Loredati-svg/Custom_Keyboard/Images/Bot_layout.png

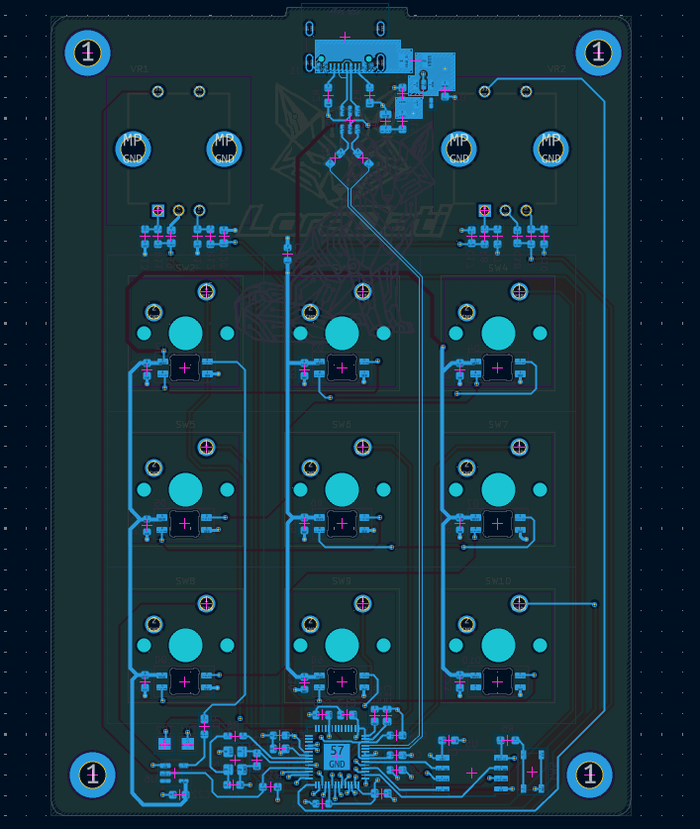
Images/Bot_layout.png
