Loredati-svg/Custom_Keyboard/Images/GND_Plane.png

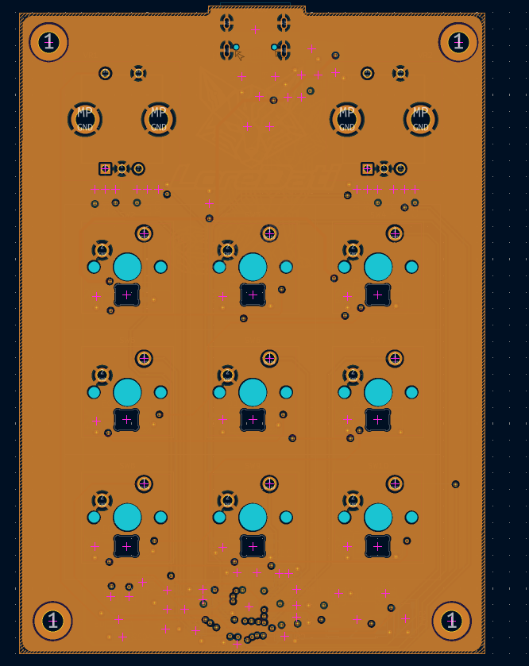
Images/GND_Plane.png
