Loredati-svg/Custom_Keyboard/Images/POWER_Plane.png

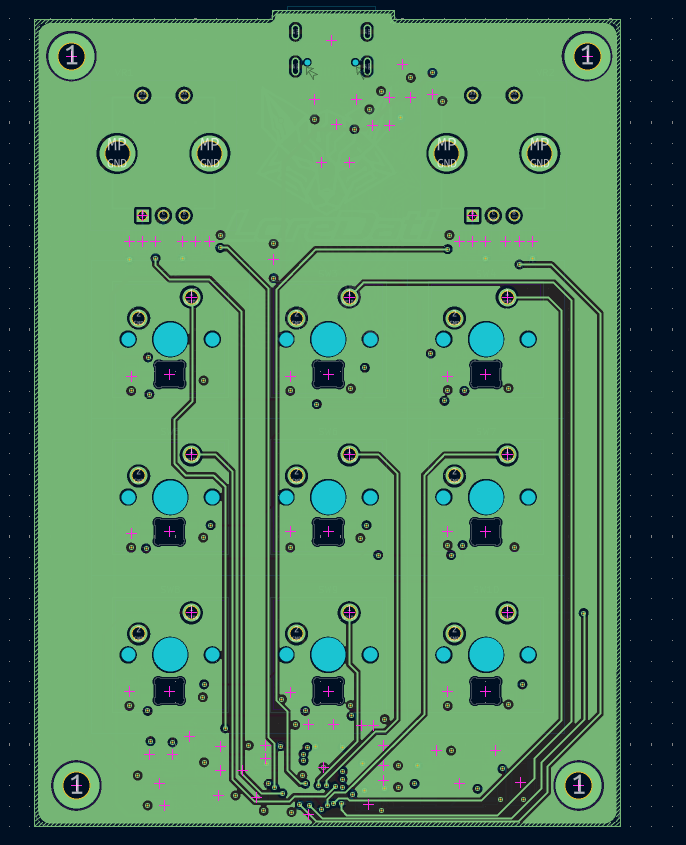
Images/POWER_Plane.png
