Loredati-svg/Custom_Keyboard/Images/Top_layout.png

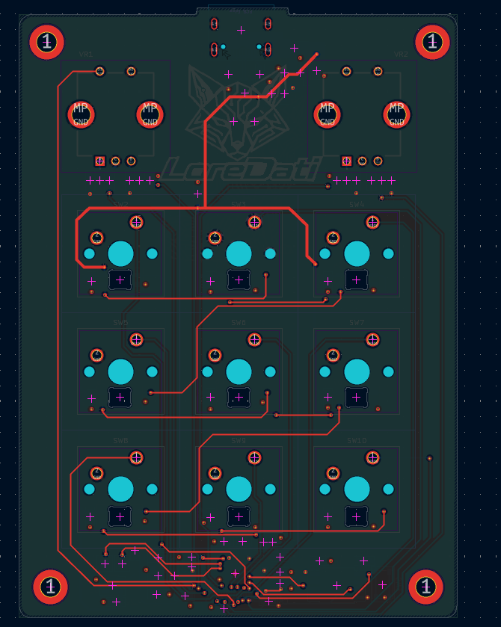
Images/Top_layout.png
