Loredati-svg/Custom_Keyboard/Kicad_Project/Custom_keyboard/Custom_keyboard.pdf

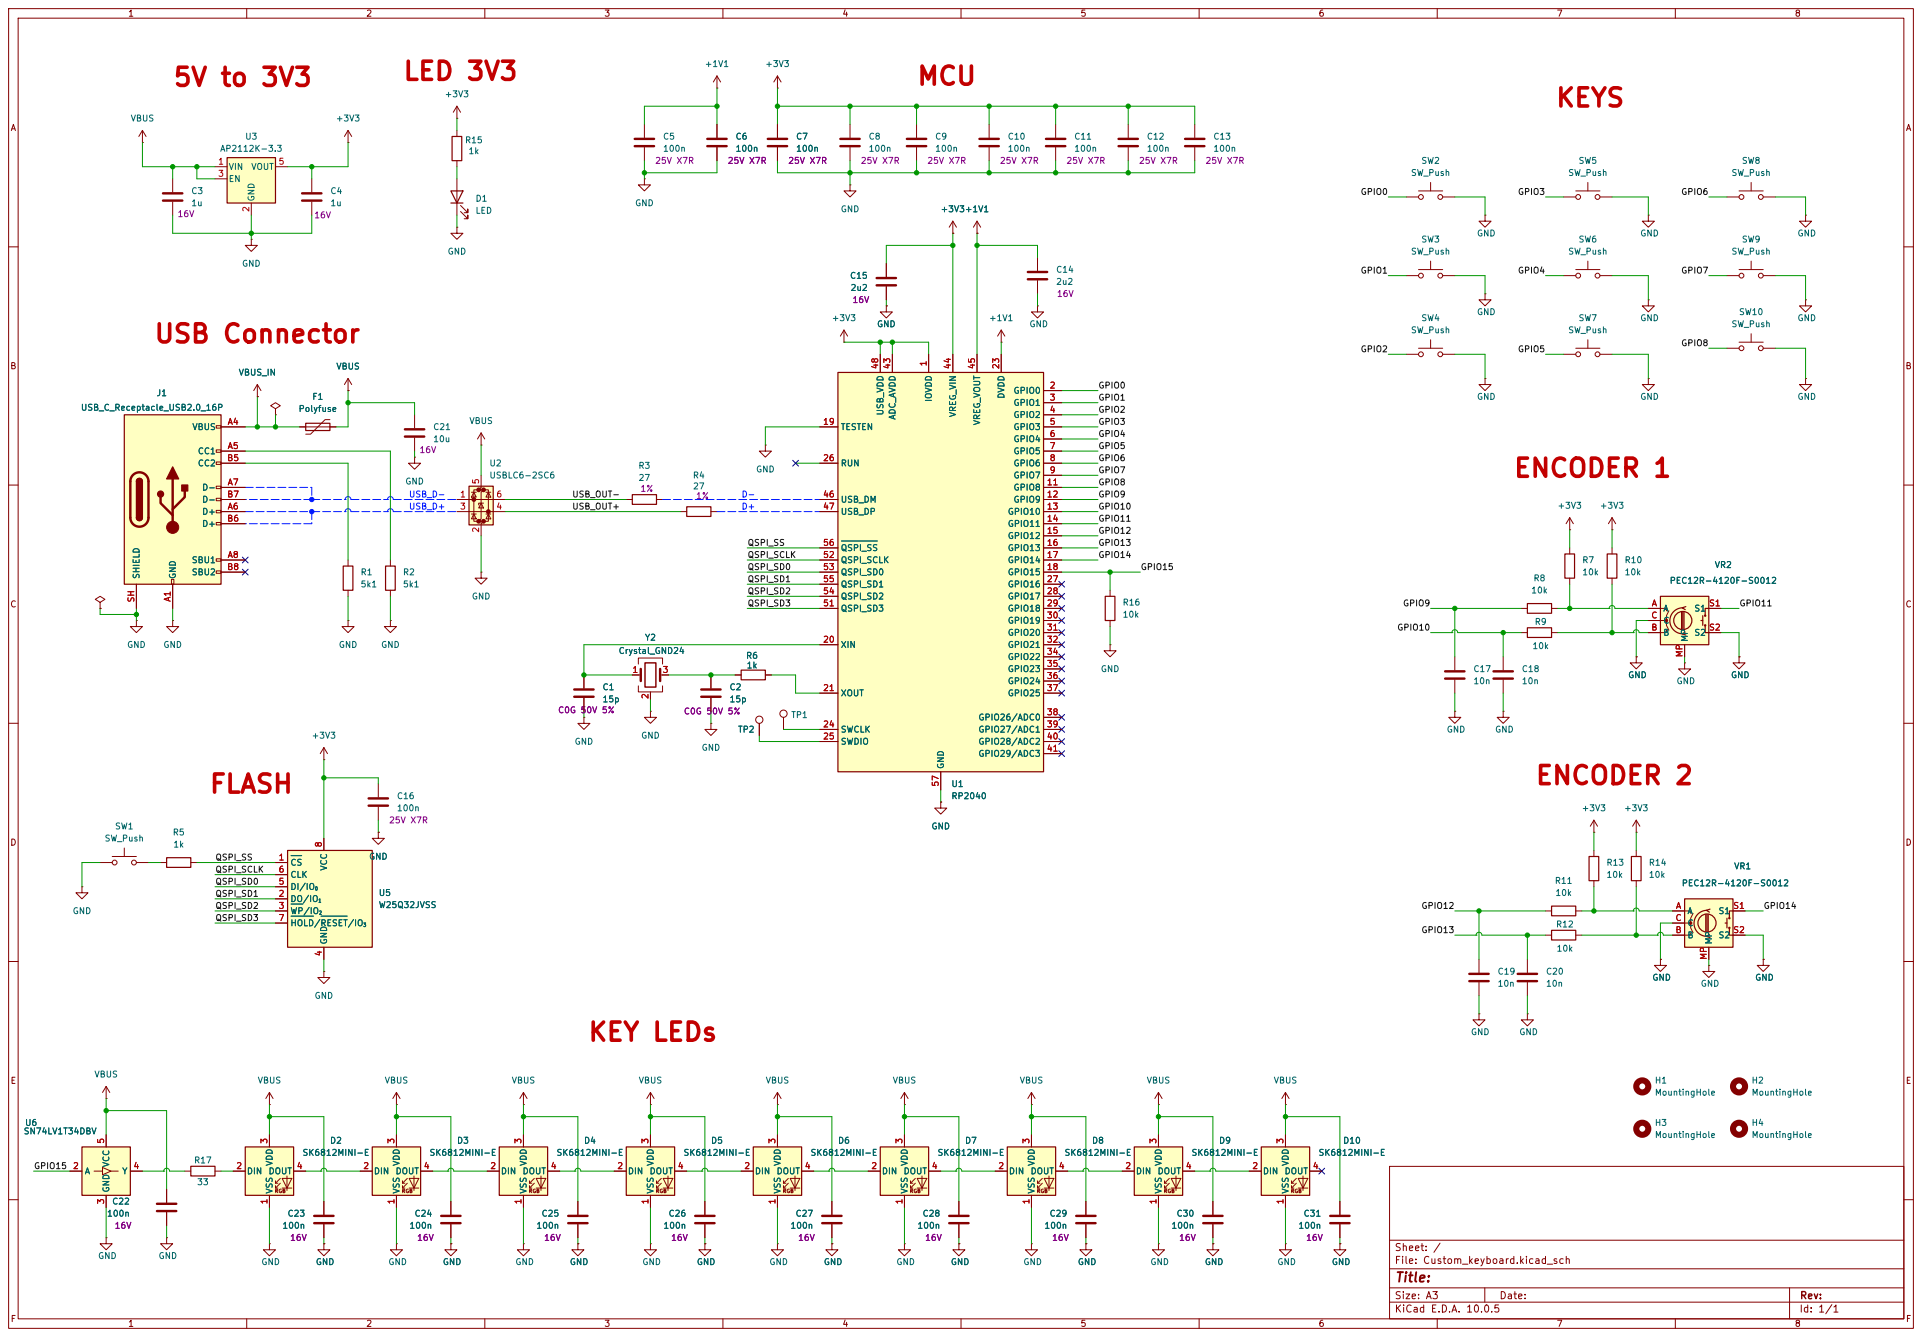
[picture p7: page 1]

8 U5W25Q32JVSS VSS RGB 1 DIN 2 VDD

3 DOUT 4 GNDU5W25Q32JVSS CS 1 DO/IO1 2 WP/IO2 3 GND

4 DI/IO0 5 CLK 6 HOLD/RESET/IO3 7 VCC

Size: A3 | Rev: | F Date:
KiCad E.D.A. 10.0.5 | Id: 1/1
