Loredati-svg/Custom_Keyboard/Kicad_Project/Custom_keyboard/Custom_keyboard.kicad_pcb

## KiCad design Kicad_Project/Custom_keyboard/Custom_keyboard.kicad_pcb (2026-10-20)

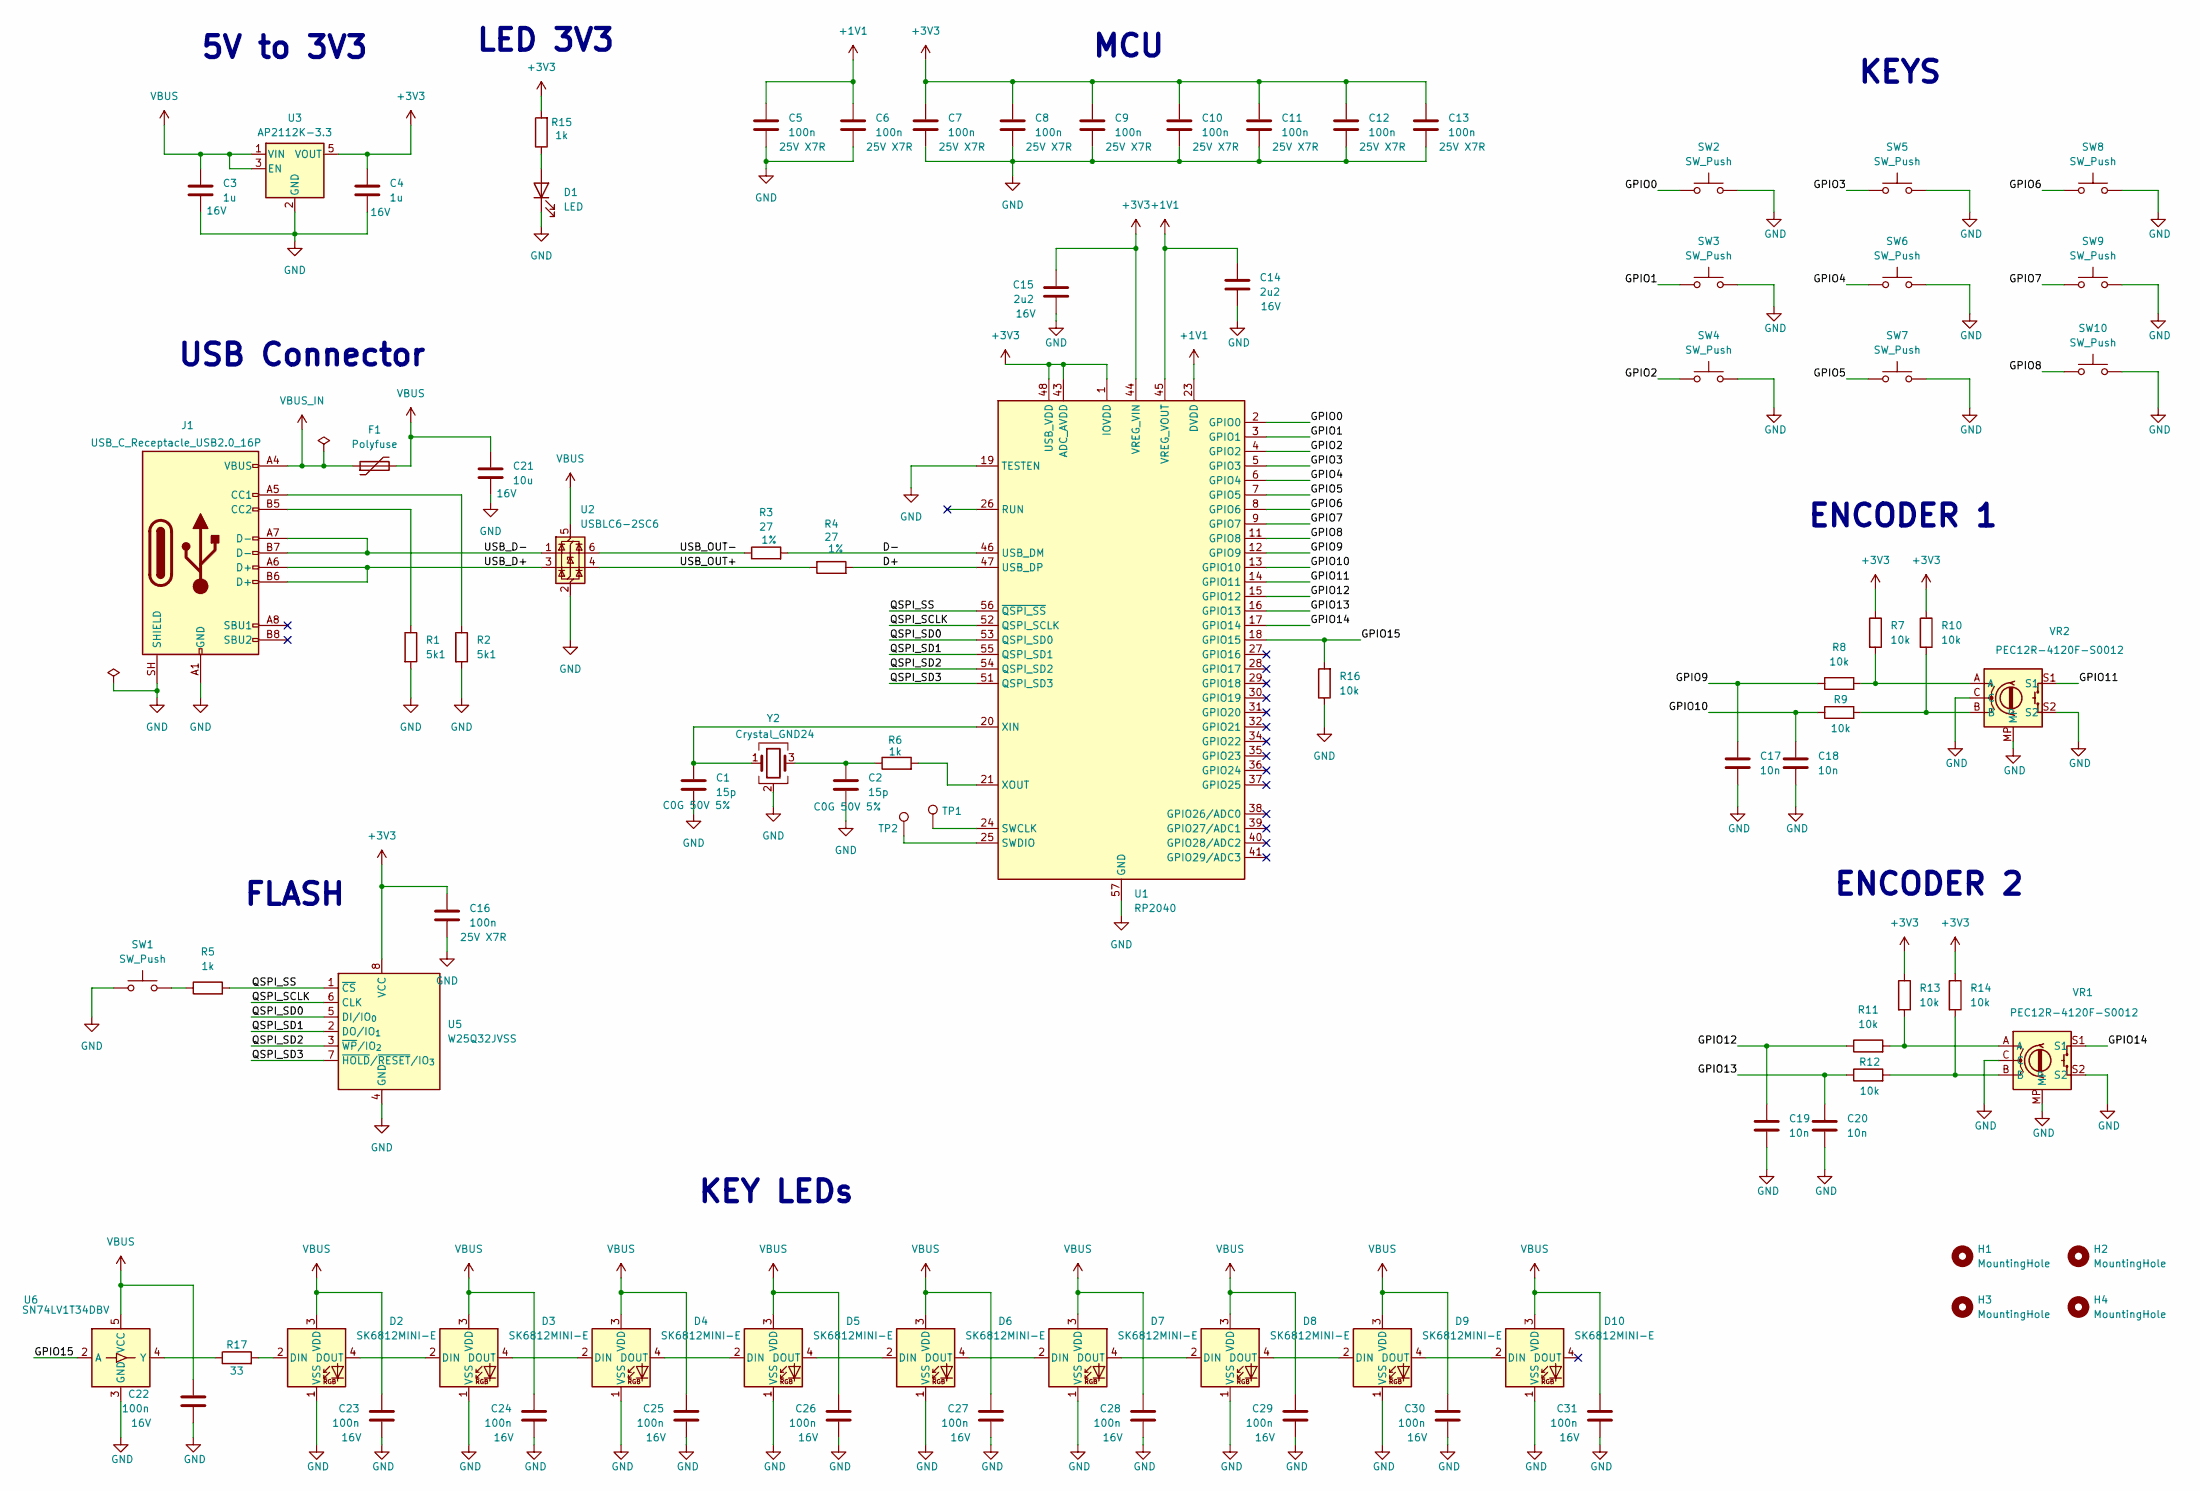
[picture p8: schematic Custom_keyboard.kicad_sch]

Parts:
C1, C2: 15p; C_0603_1608Metric; LCSC C20616249
C3, C4: 1u; C_0603_1608Metric; LCSC C5199872
C5, C6, C7, C8, C9, C10, C11, C12, C13, C16, C22, C23, C24, C25, C26, C27, C28, C29, C30, C31: 100n; C_0603_1608Metric; LCSC C1590
C14, C15: 2u2; C_0603_1608Metric; LCSC C43922
C17, C18, C19, C20: 10n; C_0603_1608Metric; LCSC C519406
C21: 10u; C_0603_1608Metric; LCSC C91606
D1: LED; LED_0805_2012Metric; LCSC C497951
D2, D3, D4, D5, D6, D7, D8, D9, D10: SK6812MINI-E; LED_SK6812MINI-E_3.2x2.8mm_P1.5mm_ReverseMount; LCSC C5149201
F1: Polyfuse; Fuse_1206_3216Metric; LCSC C371166
H1, H2, H3, H4: MountingHole; MountingHole_3.2mm_M3_ISO14580_Pad
J1: USB_C_Receptacle_USB2.0_16P; USB_C_Receptacle_GCT_USB4105-xx-A_16P_TopMnt_Horizontal; LCSC C3020560
R1, R2: 5k1; R_0603_1608Metric_Pad0.98x0.95mm_HandSolder; LCSC C2907044
R3, R4: 27; R_0603_1608Metric_Pad0.98x0.95mm_HandSolder; LCSC C2907136
R5, R6, R15: 1k; R_0603_1608Metric_Pad0.98x0.95mm_HandSolder; LCSC C2907002
R7, R8, R9, R10, R11, R12, R13, R14, R16: 10k; R_0603_1608Metric_Pad0.98x0.95mm_HandSolder; LCSC C2906982
R17: 33; R_0603_1608Metric_Pad0.98x0.95mm_HandSolder; LCSC C2909394
SW1: SW_Push; SW_SPST_PTS810; LCSC C116501
SW2, SW3, SW4, SW5, SW6, SW7, SW8, SW9, SW10: SW_Push; SW_Cherry_MX_1.00u_PCB; LCSC CPG151101D01
TP1: TestPoint_Pad_1.5x1.5mm
TP2: TestPoint; TestPoint_Pad_1.5x1.5mm
U1: RP2040; QFN-56-1EP_7x7mm_P0.4mm_EP3.2x3.2mm; LCSC C2040
U2: USBLC6-2SC6; SOT-23-6; LCSC C2827654
U3: AP2112K-3.3; SOT-23-5; LCSC C23380830
U5: W25Q32JVSS; SOIC-8_5.3x5.3mm_P1.27mm; LCSC C179173
U6: SN74LV1T34DBV; SOT-23-5; LCSC C100024
VR1, VR2: PEC12R-4120F-S0012; PEC12R4120FS0012; Manufacturer_Part_Number PEC12R-4120F-S0012; Mouser Part Number 652-PEC12R-4120F-S12
Y2: Crystal_GND24; Crystal_SMD_3225-4Pin_3.2x2.5mm; LCSC C20625731

Connections:
+1V1: C5.1, C6.1, C14.1, U1.23 (DVDD), U1.45 (VREG_VOUT), U1.50 (DVDD)
+3V3: C4.1, C7.1, C8.1, C9.1, C10.1, C11.1, C12.1, C13.1, C15.1, C16.1, R7.1, R10.1, R13.1, R14.1, R15.2, U1.1 (IOVDD), U1.10 (IOVDD), U1.22 (IOVDD), U1.33 (IOVDD), U1.42 (IOVDD), U1.43 (ADC_AVDD), U1.44 (VREG_VIN), U1.48 (USB_VDD), U1.49 (IOVDD), U3.5 (VOUT), U5.8 (VCC)
/D+: R4.2, U1.47 (USB_DP)
/D-: R3.2, U1.46 (USB_DM)
/GPIO0: SW2.1, U1.2 (GPIO0)
/GPIO1: SW3.1, U1.3 (GPIO1)
/GPIO2: SW4.1, U1.4 (GPIO2)
/GPIO3: SW5.1, U1.5 (GPIO3)
/GPIO4: SW6.1, U1.6 (GPIO4)
/GPIO5: SW7.1, U1.7 (GPIO5)
/GPIO6: SW8.1, U1.8 (GPIO6)
/GPIO7: SW9.1, U1.9 (GPIO7)
/GPIO8: SW10.1, U1.11 (GPIO8)
/GPIO9: C17.1, R8.1, U1.12 (GPIO9)
/GPIO10: C18.1, R9.1, U1.13 (GPIO10)
/GPIO11: U1.14 (GPIO11), VR2.S1
/GPIO12: C19.1, R11.1, U1.15 (GPIO12)
/GPIO13: C20.1, R12.1, U1.16 (GPIO13)
/GPIO14: U1.17 (GPIO14), VR1.S1
/GPIO15: R16.2, U1.18 (GPIO15), U6.2 (A)
/QSPI_SCLK: U1.52 (QSPI_SCLK), U5.6 (CLK)
/QSPI_SD0: U1.53 (QSPI_SD0), U5.5 (DI/IO_{0})
/QSPI_SD1: U1.55 (QSPI_SD1), U5.2 (DO/IO_{1})
/QSPI_SD2: U1.54 (QSPI_SD2), U5.3 (~WP/IO_{2})
/QSPI_SD3: U1.51 (QSPI_SD3), U5.7 (~HOLD/~RESET/IO_{3})
/QSPI_SS: R5.2, U1.56 (~QSPI_SS), U5.1 (~CS)
/USB_D+: J1.A6 (D+), J1.B6 (D+), U2.3 (I/O2)
/USB_D-: J1.A7 (D-), J1.B7 (D-), U2.1 (I/O1)
/USB_OUT+: R4.1, U2.4 (I/O2)
/USB_OUT-: R3.1, U2.6 (I/O1)
GND: C1.2, C2.2, C3.2, C4.2, C5.2, C6.2, C7.2, C8.2, C9.2, C10.2, C11.2, C12.2, C13.2, C14.2, C15.2, C16.2, C17.2, C18.2, C19.2, C20.2, C21.2, C22.2, C23.2, C24.2, C25.2, C26.2, C27.2, C28.2, C29.2, C30.2, C31.2, D1.1 (K), D2.1 (VSS), D3.1 (VSS), D4.1 (VSS), D5.1 (VSS), D6.1 (VSS), D7.1 (VSS), D8.1 (VSS), D9.1 (VSS), D10.1 (VSS), J1.A1 (GND), J1.A12 (GND), J1.B1 (GND), J1.B12 (GND), J1.SH (SHIELD), R1.2, R2.2, R16.1, SW1.1, SW2.2, SW3.2, SW4.2, SW5.2, SW6.2, SW7.2, SW8.2, SW9.2, SW10.2, U1.19 (TESTEN), U1.57 (GND), U2.2 (GND), U3.2 (GND), U5.4 (GND), U6.3 (GND), VR1.C, VR1.MP, VR1.S2, VR2.C, VR2.MP, VR2.S2, Y2.2 (G), Y2.4 (G)
unnamed: C2.1, R6.1, Y2.3
unnamed: D1.2 (A), R15.1
unnamed: D2.2 (DIN), R17.2
unnamed: D2.4 (DOUT), D3.2 (DIN)
unnamed: D3.4 (DOUT), D4.2 (DIN)
unnamed: D4.4 (DOUT), D5.2 (DIN)
unnamed: D5.4 (DOUT), D6.2 (DIN)
unnamed: D6.4 (DOUT), D7.2 (DIN)
unnamed: D7.4 (DOUT), D8.2 (DIN)
unnamed: D8.4 (DOUT), D9.2 (DIN)
unnamed: D9.4 (DOUT), D10.2 (DIN)
unnamed: J1.A5 (CC1), R2.1
unnamed: J1.B5 (CC2), R1.1
unnamed: R5.1, SW1.2
unnamed: R7.2, R8.2, VR2.A
unnamed: R9.2, R10.2, VR2.B
unnamed: R11.2, R13.2, VR1.A
unnamed: R12.2, R14.2, VR1.B
unnamed: TP1.1 (1_1), U1.24 (SWCLK)
unnamed: TP2.1 (1_1), U1.25 (SWDIO)
unnamed: C1.1, U1.20 (XIN), Y2.1
unnamed: R6.2, U1.21 (XOUT)
unnamed: R17.1, U6.4 (Y)
VBUS: C3.1, C21.1, C22.1, C23.1, C24.1, C25.1, C26.1, C27.1, C28.1, C29.1, C30.1, C31.1, D2.3 (VDD), D3.3 (VDD), D4.3 (VDD), D5.3 (VDD), D6.3 (VDD), D7.3 (VDD), D8.3 (VDD), D9.3 (VDD), D10.3 (VDD), F1.2, U2.5 (VBUS), U3.1 (VIN), U3.3 (EN), U6.5 (VCC)
VBUS_IN: F1.1, J1.A4 (VBUS), J1.A9 (VBUS), J1.B4 (VBUS), J1.B9 (VBUS)

Notes on the sheet:
LED 3V3
KEY LEDs
MCU
USB Connector
ENCODER 1
FLASH
5V to 3V3
KEYS
ENCODER 2

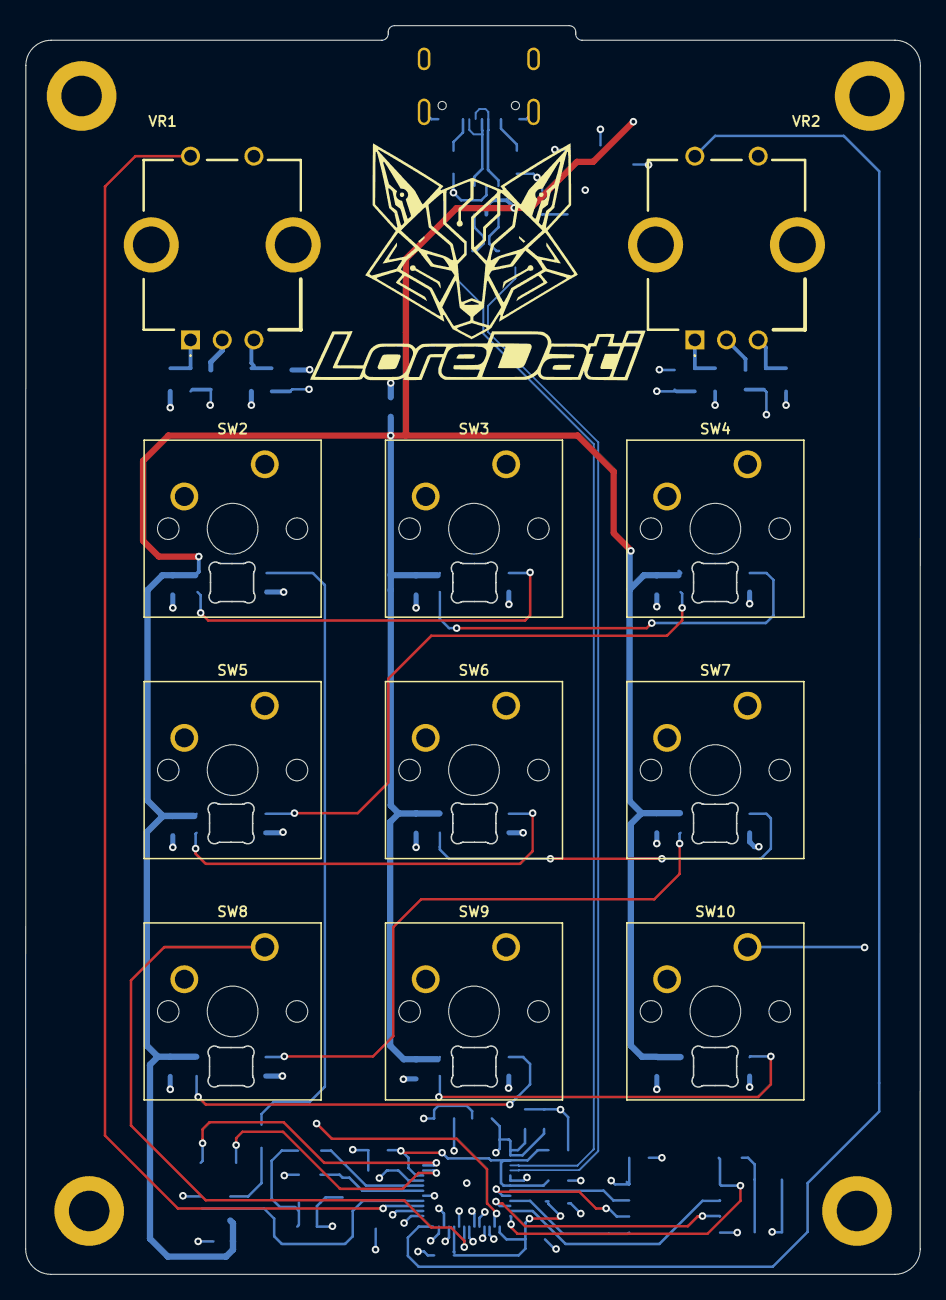
[picture p9: board Custom_keyboard.kicad_pcb from above]

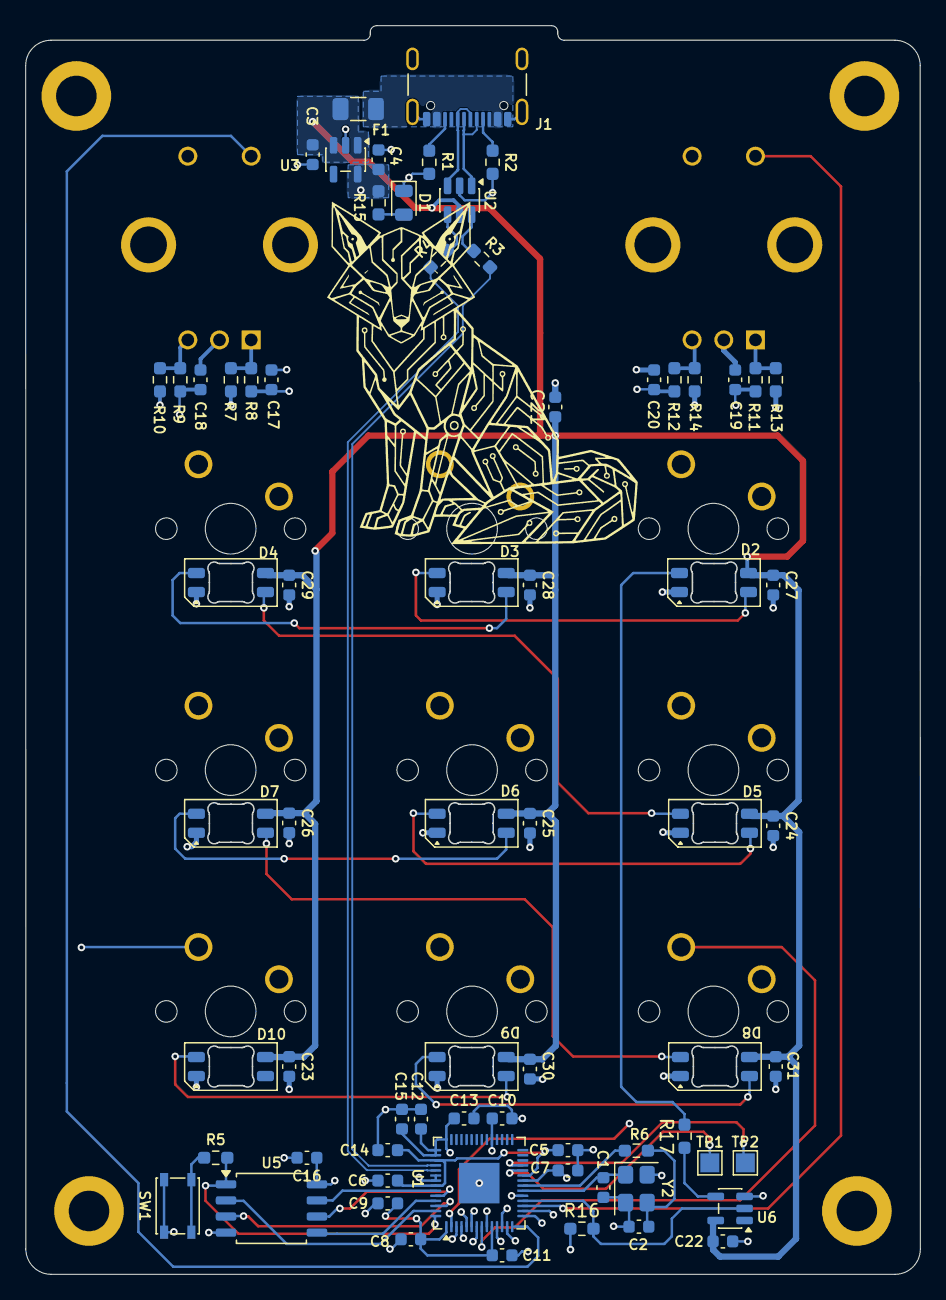
[picture p10: board Custom_keyboard.kicad_pcb from below]

Board: 4 copper layers, 70.6 x 98.5 mm, 84 parts (69 on the bottom side), 56 nets.
