Loredati-svg/Custom_Keyboard/(commit log)

2026-10-12 Update README with project details and specifications
    Added detailed project description, features, block diagram, hardware specifications, design notes, PCB details, pinout, flashing instructions, firmware plans, repository structure, project status, and author information.
2026-10-12 Add layout and power plane images to README
    Added additional images for layout and power planes.
2026-10-12 Add KiCad project, libraries and 3D models
    [Custom_keyboard.kicad_pcb, Custom_keyboard.kicad_sch, Kailh Polia.step]
2026-10-12 rounded corners in the bottom planes
    [Custom_keyboard.kicad_pcb]
2026-10-16 changed board shape
    [Custom_keyboard-B_Cu.gbl, Custom_keyboard-B_Mask.gbs, Custom_keyboard-B_Paste.gbp, Custom_keyboard-B_Silkscreen.gbo, Custom_keyboard-Edge_Cuts.gm1, Custom_keyboard-F_Cu.gtl, Custom_keyboard-F_Mask.gts, Custom_keyboard-F_Paste.gtp]
2026-10-19 changed relative path for the components in the project
    [Custom_keyboard.kicad_pcb]
2026-10-20 Use shared Kicad_Libs instead of project-specific libraries
    - Project parts moved to Kicad_Libs (symbol, footprint, 3D, datasheet)
    - Lib tables point to ${KIPRJMOD}/../KiCad_Libs (link via bring_libs.bat)
    - Schematic/PCB references (lib ids, footprints, 3D paths, datasheets)
    updated to the Kicad_Libs libraries; no design changes
    - Removed the old project-specific library folder
    [Custom_keyboard.kicad_pcb, Custom_keyboard.kicad_sch, Kailh Polia.step]
2026-10-22 Update README with library setup instructions
    Added instructions for using shared KiCad libraries.
