Loredati-svg/Custom_Keyboard/(notices)

Notices in the files:
README.md:
License: CERN-OHL-P
